HoldenLab/microscope-focus-lock/focus-controller/README.md

# FocusShifter: Arduino-based microscope autofocus control

Control software
Arduino Libraries required
-Adafuit Motor Shield V2 Library
- ArduinoSerialCommand: from https://github.com/scogswell/ArduinoSerialCommand but latest version they changed the interface
	- need the 2017 version, so hardcoded it. It's under GPL license.

connect to serial monitor: 9600 baud. Carriage return
